ethanluoeng/Dog_Communication_Device/Pictures/IMG_5925.jpg

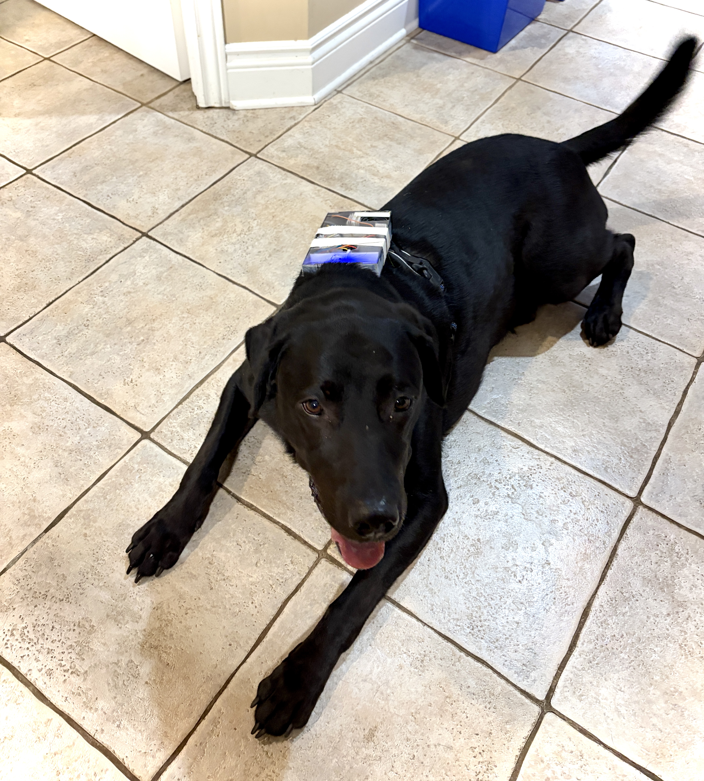
Pictures/IMG_5925.jpg
