ethanluoeng/Dog_Communication_Device/Electrical_Schematics/Schematic_v1/Schematic_v1.pdf

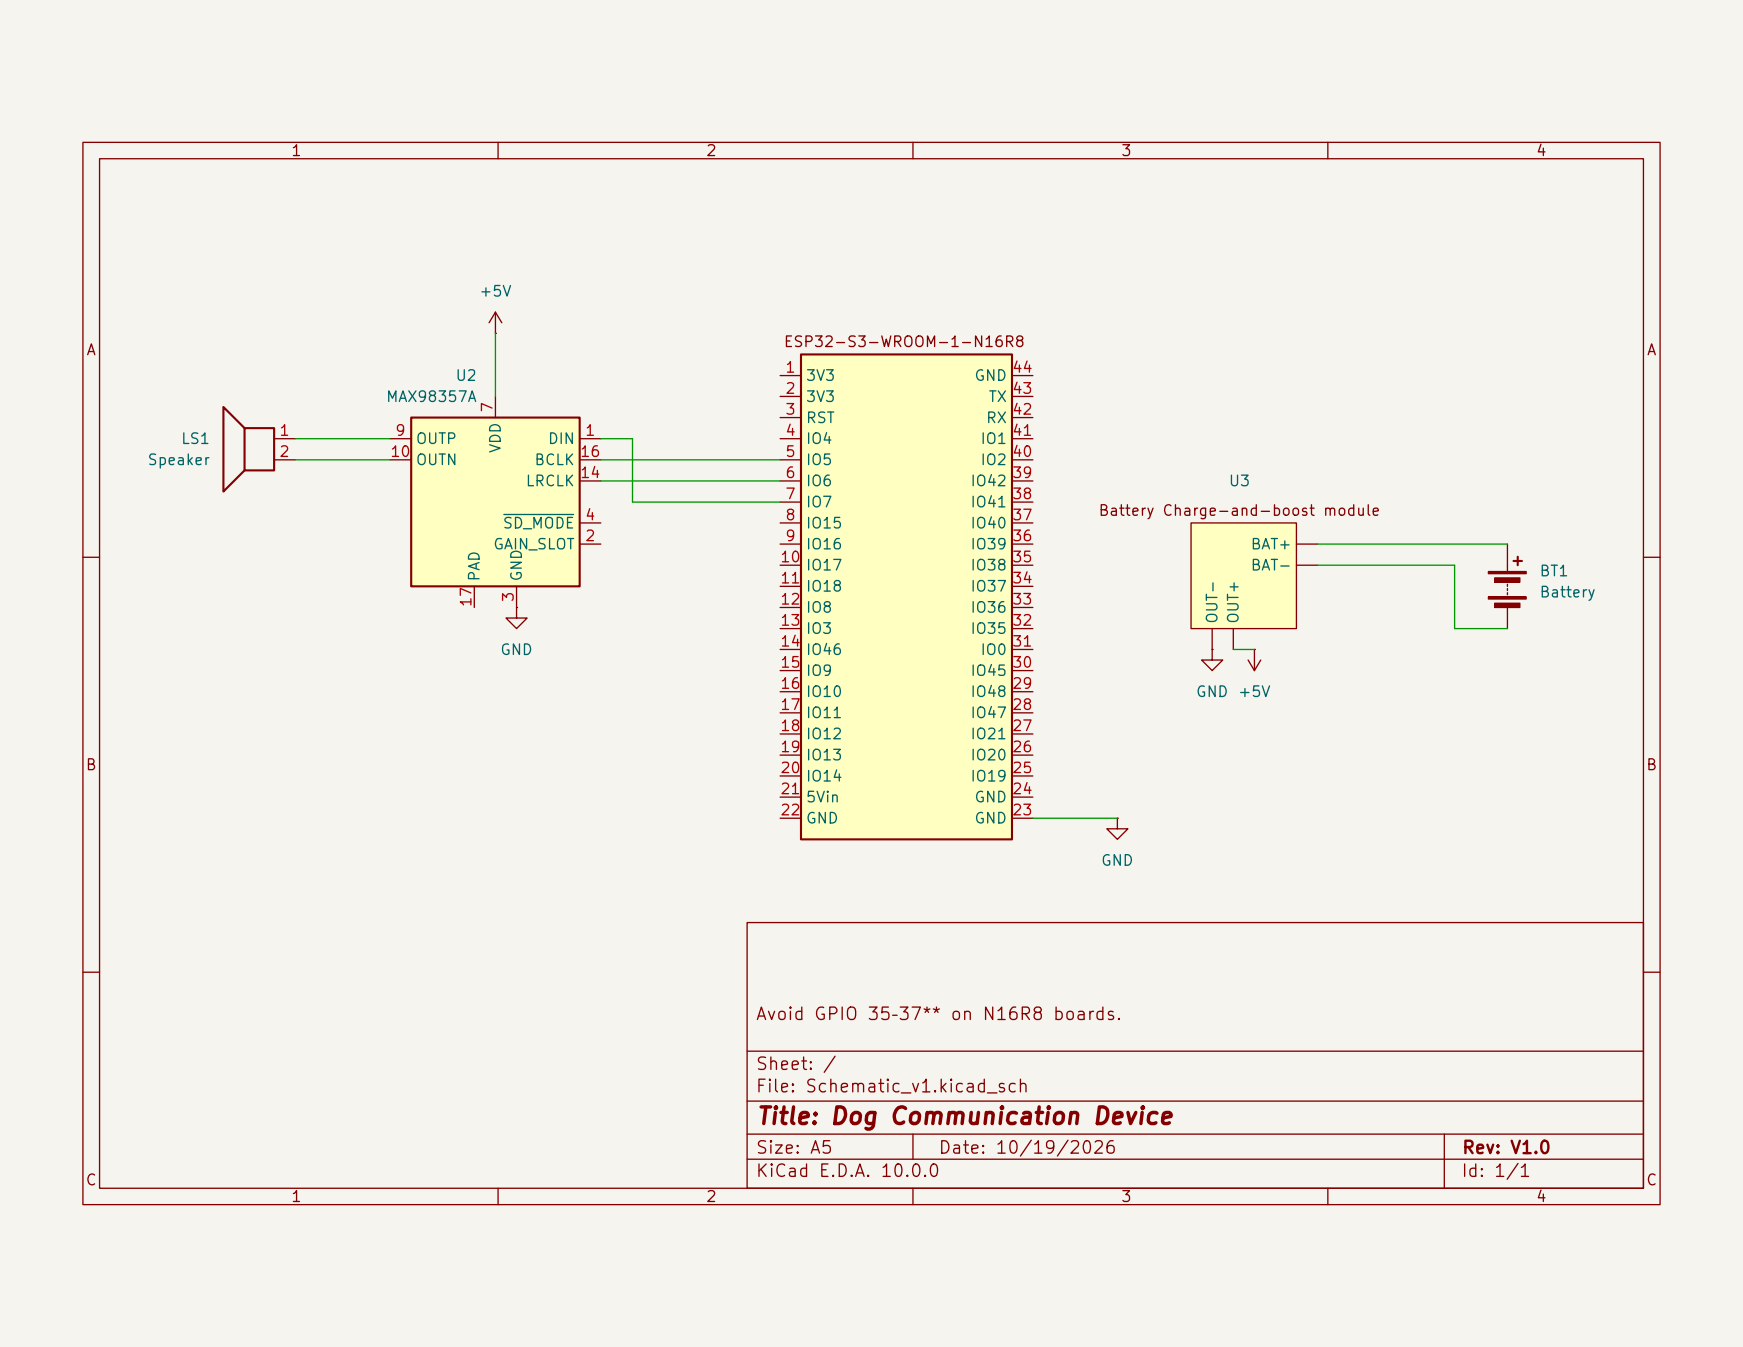
[picture p6: page 1]
