ethanluoeng/Dog_Communication_Device/(commit log)

2026-08-30 Finished testing esp32-s3-devkit
    [Schematic_v1.kicad_pcb, Schematic_v1.kicad_sch]
2026-08-31 Phase 1 programming complete
    [partitions.csv]
2026-09-08 Revise README.md for improved project description
    Updated the project description for clarity and added details about the wearable device's functionality.
2026-10-15 Enhance README with detailed project information
    Expanded project details, added sections on project structure, bill of materials, wiring, build instructions, and audio clip integration.
2026-10-15 Revise README for clarity and formatting
    Updated the Bill of Materials and installation instructions for clarity and formatting.
2026-10-19 finish schematic
    [Schematic_v1.kicad_sch]
2026-10-19 Update README with schematic and eng decisions
    Added wiring, schematics, and bill of materials sections to README.
2026-10-20 Fix typo in 'Schematic' section heading
