ethanluoeng/Dog_Communication_Device/Pictures/IMG_5903.JPG

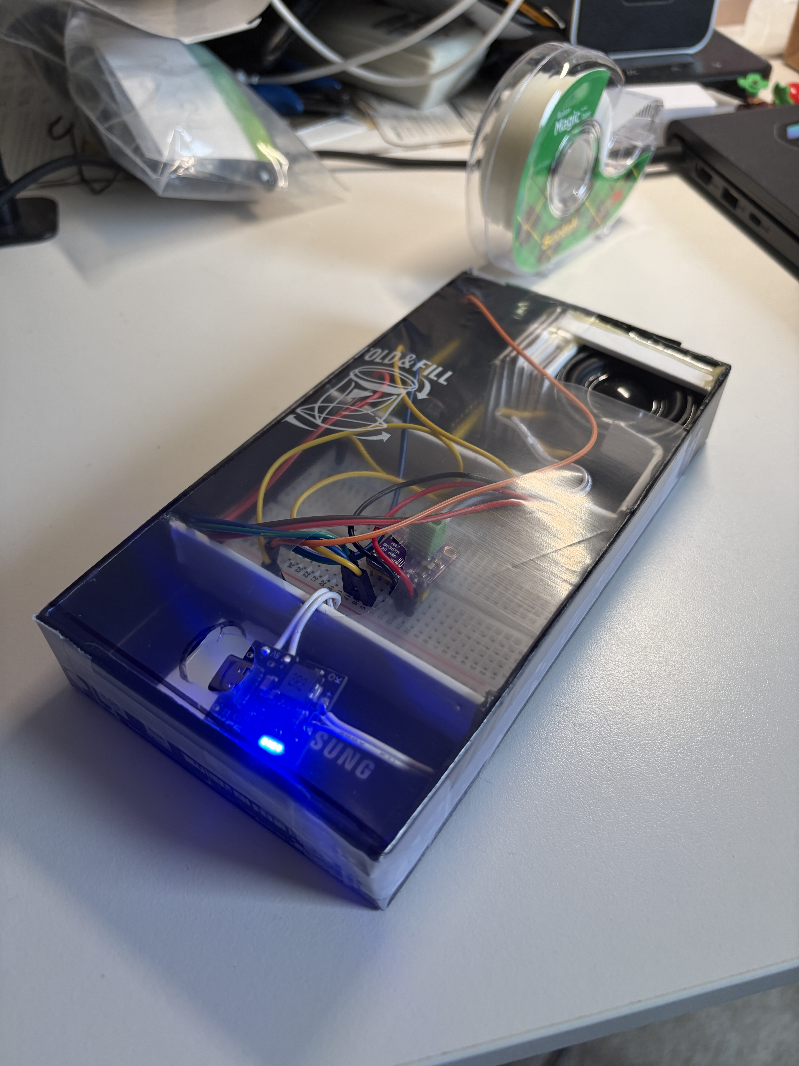
Pictures/IMG_5903.JPG
