ethanluoeng/Dog_Communication_Device/Pictures/IMG_5897.JPG

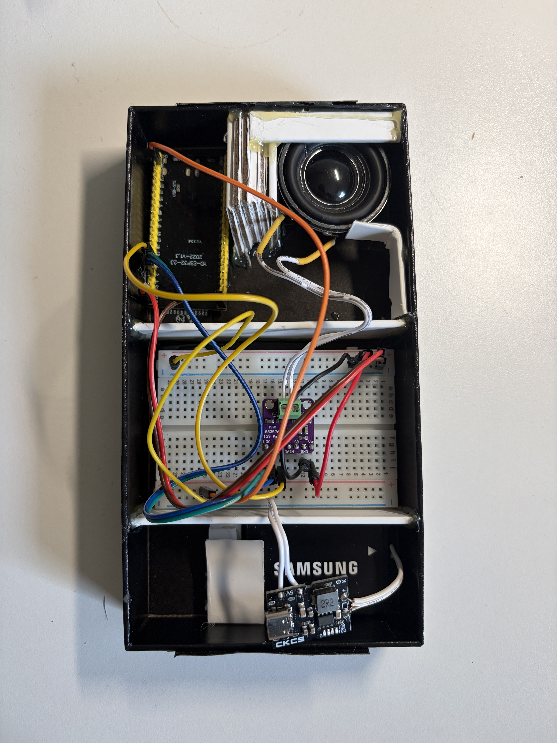
[picture p2: Pictures/IMG_5897.JPG]
Pictures/IMG_5897.JPG
